afonsus1997/Tamagotchi-thing/README.md

# Tamagotchi Thing

Just a dumb attempt to make a tamagotch.

Based on the amazing work of [jcrona](https://github.com/jcrona)!

#### Credits

3D models:
 - Kailh buttons by Manh Le
