afonsus1997/Tamagotchi-thing/Hardware/Tamagotchi-thing/Tamagotchi-thing.kicad_pcb

## KiCad design Hardware/Tamagotchi-thing/Tamagotchi-thing.kicad_pcb (2025-07-16)

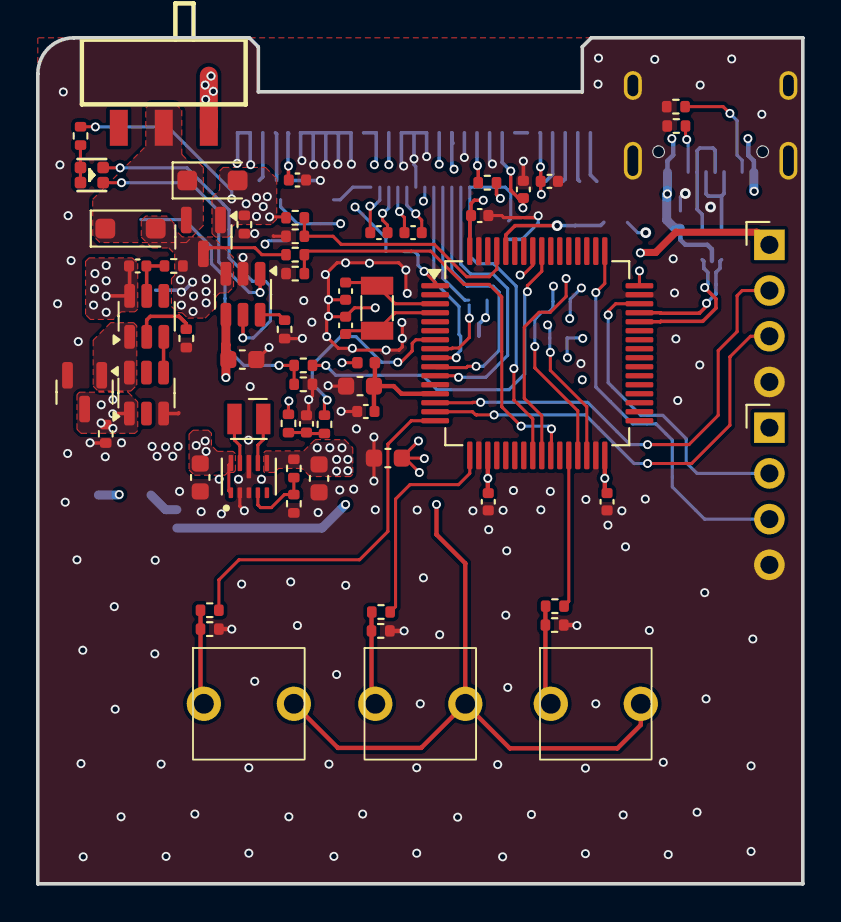
[picture p1: board Tamagotchi-thing.kicad_pcb from above]

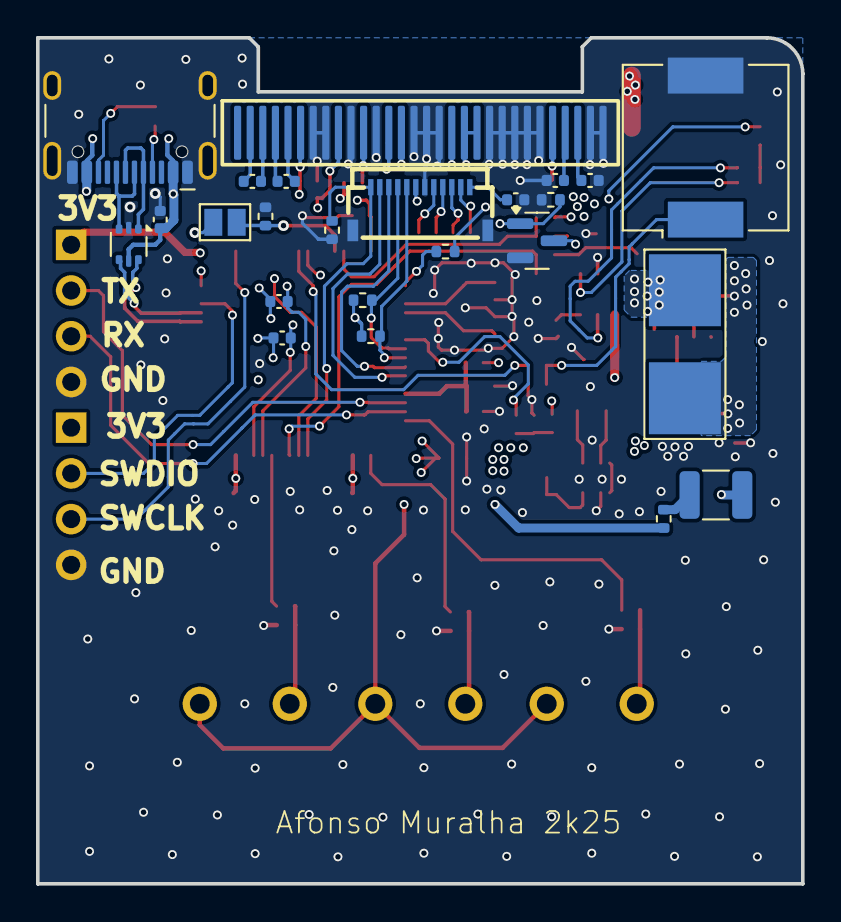
[picture p2: board Tamagotchi-thing.kicad_pcb from below]

Board: 4 copper layers, 42.5 x 47.0 mm, 86 parts (24 on the bottom side), 69 nets.

Parts:
BT1: Battery; Battery_Pads_4x4
C4, C5, C6: 1uF; C_0402_1005Metric
C7, C9, C10, C11, C12: 2.2uF; C_0402_1005Metric
C8: 4.7uF; C_0402_1005Metric
C13, C14: 12pF; C_0402_1005Metric
C15, C19, C20, C21, C24, C28: 100nF; C_0402_1005Metric
C18: 10nF; C_0603_1608Metric
C22: 1uF; C_0603_1608Metric
C23: 10nF; C_0402_1005Metric
C25, C27: 10uF; C_0603_1608Metric
C26: 22uF; C_0603_1608Metric
D1, D2: D_Schottky; D_SOD-123F
D3: LED_Dual_KKA; LED-SMD_4P-L1.6-W1.5-TL-1
J1: Conn_01x14; R_1210_3225Metric
J3: Conn_01x30; FFC-SMD_12P-P0.50_FH34SRJ-12S-0.5SH
J5: Conn_01x30; sh1106-1.3inch-oled_1
J6: USB_C_Receptacle_USB2.0; USB_C_Receptacle_HCTL_HC-TYPE-C-16P-01A
J7, J8: Conn_01x04; PinHeader_1x04_P2.54mm_Horizontal
JP1: SolderJumper_2_Open; SolderJumper-2_P1.3mm_Open_Pad1.0x1.5mm
L1: 39nH; L_0402_1005Metric
L2: 0.47uH; L_Wurth_WE-LQSH-2010
LS1: Speaker_Crystal; Buzzer_CUI_CPT-9019S-SMT
Q1: BSS138; SOT-23
Q3, Q4: AO3401A; SOT-23
Q5: FS8205A; SOT-23-6
R1: 15; R_0402_1005Metric
R2, R3, R4: 10k; R_0402_1005Metric
R6, R7, R11, R15, R16, R17, R18, R19, R22, R28, R32, R33: 100k; R_0402_1005Metric
R8, R9: 4.7k; C_0402_1005Metric
R10: 390k; C_0402_1005Metric
R12, R21, R27, R31: 330; R_0402_1005Metric
R13, R14: 5.1k; R_0402_1005Metric
R20, R34: 0; R_0402_1005Metric
R25, R35: 100; R_0402_1005Metric
R26, R36: 1k; R_0402_1005Metric
R37: 511k; R_0402_1005Metric
R38: 91k; R_0402_1005Metric
R39: 2k; R_0402_1005Metric
R42: 1.6k; R_0402_1005Metric
SW2, SW4, SW5: SW_Push; Kailh_mouse_button
SW6: SW_SPDT_321; SW-SMD_SK-3245S-L1-A-1
U1: USBLC6-2P6; SOT-666
U2: STM32L073RBTx; LQFP-64_10x10mm_P0.5mm
U3: DW01A; SOT-23-6
U4: TPS63802DLAR; VREG_TPS63802DLAR
U5: TP4057; TSOT-23-6
Y1: 32768Hz - 12,5 pF; Crystal_SMD_3215-2Pin_3.2x1.5mm

Connections:
3V3: C7.2, C10.2, C18.1, C19.1, C20.1, C21.1, C26.1, J3.7, J5.6, J5.9, J5.13, J7.1, J8.1, JP1.1 (A), L1.1, R1.2, R3.1, R4.1, R7.2, R8.2, R9.2, R11.1, R20.1, R37.1, SW2.2, SW4.2, SW5.2, U2.19 (VDD), U2.32 (VDD), U2.48 (VDD_USB), U2.64 (VDD), U4.6 (VOUT)
3V3A: C22.1, C23.1, L1.2, U2.13 (VDDA)
/MCU/BOOT0: JP1.2 (B), R15.1, U2.60 (BOOT0)
/MCU/LCD2.SCL: J3.9, R4.2, U2.8 (I2C3_SCL)
/MCU/LCD2.SDA: J3.8, R3.2, U2.9 (I2C3_SDA)
/MCU/LCD2_A0: J3.10, U2.10 (PC2)
/MCU/LCD2_BL_EN: Q1.1 (G), R2.1, U2.57 (TIM3_CH2)
/MCU/LCD2_CS: J3.12, R6.1, U2.24 (PC4)
/MCU/LCD2_RES: J3.11, U2.11 (PC3)
/MCU/OLED.SCL: J5.18, R8.1, U2.29 (I2C2_SCL)
/MCU/OLED.SDA: J5.19, J5.20, R9.1, U2.30 (I2C2_SDA)
/MCU/OLED_RST: J5.14, U2.25 (PC5)
/MCU/OSC_32_IN: C13.1, U2.3 (RCC_OSC32_IN), Y1.1
/MCU/OSC_32_OUT: C14.1, U2.4 (RCC_OSC32_OUT), Y1.2
/MCU/RST: R12.2, U2.7 (NRST)
/MCU/SPK: R25.2, U2.56 (TIM3_CH1)
/MCU/SWCLK: J7.3, U2.49 (SYS_SWCLK)
/MCU/SWDIO: J7.2, U2.46 (SYS_SWDIO)
/MCU/SW_CENTER: R27.1, U2.17 (PA3)
/MCU/SW_LEFT: R21.1, U2.16 (PA2)
/MCU/SW_RIGHT: R31.1, U2.28 (PB2)
/MCU/UART_RX: J8.3, U2.15 (USART4_RX)
/MCU/UART_TX: J8.2, U2.14 (USART4_TX)
/MCU/USB_D_N: U1.6 (I/O1), U2.44 (USB_DM)
/MCU/USB_D_P: U1.4 (I/O2), U2.45 (USB_DP)
/MCU/USB_D_RAW_N: J6.A7 (D-), J6.B7 (D-), U1.1 (I/O1)
/MCU/USB_D_RAW_P: J6.A6 (D+), J6.B6 (D+), U1.3 (I/O2)
/MCU/VBAT_SENSE: R18.2, R19.1, U2.26 (ADC_IN8)
/MCU/VBUS_SENSE: R16.2, R17.1, U2.61 (PB8)
/OLED/BS1: J5.11, R7.1
GND: C4.2, C7.1, C8.1, C10.1, C11.1, C13.2, C14.2, C15.2, C18.2, C19.2, C20.2, C21.2, C22.2, C23.2, C25.2, C26.2, C27.2, C28.2, J3.6, J3.MP (MountPin), J5.7, J5.8, J5.10, J5.12, J5.15, J5.16, J5.17, J5.21, J5.22, J5.23, J5.24, J5.25, J5.29, J5.30, J6.A1 (GND), J6.A12 (GND), J6.B1 (GND), J6.B12 (GND), J6.S1 (SHIELD), J7.4, J8.4, LS1.2, Q1.2 (S), Q4.2 (S), Q5.3 (S2), R2.2, R6.2, R10.1, R13.2, R14.2, R15.2, R17.2, R19.2, R22.2, R26.2, R28.2, R32.2, R33.2, R34.2, R36.2, R38.2, R42.2, U1.2 (GND), U2.12 (VSSA), U2.18 (VSS), U2.31 (VSS), U2.47 (VSS), U2.63 (VSS), U4.2 (MODE), U4.3 (AGND), U4.8 (GND), U5.2 (GND)
GND_BAT: BT1.2 (-), C24.2, Q4.3 (D), Q5.1 (D1), R34.1, U3.6 (GND)
unnamed: C15.1, R11.2, R12.1
unnamed: D1.1 (K), D2.1 (K), Q3.2 (S), SW6.2 (B)
unnamed: D3.3 (A2), D3.4 (A1), R39.2
unnamed: D3.1 (K1), U5.1 (~CHRG)
unnamed: D3.2 (K2), U5.5 (STDBY)
unnamed: J1.1, R1.1
unnamed: J1.2, Q1.3 (D)
unnamed: C4.1, J3.1
unnamed: C5.1, J3.2
unnamed: C5.2, J3.3
unnamed: C6.1, J3.4
unnamed: C6.2, J3.5
unnamed: C12.2, J5.2
unnamed: C12.1, J5.3
unnamed: C9.2, J5.4
unnamed: C9.1, J5.5
unnamed: J5.26, R10.2
unnamed: C8.2, J5.27
unnamed: C11.2, J5.28
unnamed: J6.A5 (CC1), R14.1
unnamed: J6.B5 (CC2), R13.1
unnamed: LS1.1, R25.1, R26.1
unnamed: Q4.1 (G), Q5.6 (G1), U3.1 (OD)
unnamed: Q5.4 (G2), U3.3 (OC)
unnamed: R21.2, R22.1, SW2.1
unnamed: R27.2, R28.1, SW4.1
unnamed: R31.2, R32.1, SW5.1
unnamed: C25.1, SW6.3 (A), U4.1 (EN), U4.10 (VIN)
unnamed: R20.2, U2.1 (VLCD)
unnamed: R36.1, U3.2 (CS)
unnamed: C24.1, R35.2, U3.5 (VCC)
unnamed: R37.2, R38.1, U4.4 (FB)
unnamed: L2.1, U4.9 (L1)
unnamed: L2.2, U4.7 (L2)
unnamed: R42.1, U5.6 (PROG)
VBAT: BT1.1 (+), D2.2 (A), Q3.3 (D), R18.1, R35.1, U5.3 (BAT)
VBUS: C27.1, C28.1, D1.2 (A), J6.A4 (VBUS), J6.A9 (VBUS), J6.B4 (VBUS), J6.B9 (VBUS), Q3.1 (G), R16.1, R33.1, R39.1, U1.5 (VBUS), U5.4 (V_{CC})
