afonsus1997/Tamagotchi-thing/Software/Tamagotchi-thing/Core/Src/main.c

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
/* Includes ------------------------------------------------------------------*/
#include "main.h"
#include "adc.h"
#include "fatfs.h"
#include "i2c.h"
#include "rtc.h"
#include "spi.h"
#include "tim.h"
#include "usart.h"
#include "usb.h"
#include "gpio.h"

/* USER CODE BEGIN Includes */
#include "ssd1306.h"
#include "ssd1306_fonts.h"
#include "ui.h"
#include "userio.h"
#include "usb_user.h" 
#include "log.h"
#include "hal.h"
#include "tamalib.h"
#include "tama_user.h"
/* USER CODE END Includes */


void SystemClock_Config(void);
/* USER CODE BEGIN 0 */

void debug_blink_box(void) {
    static timestamp_t last = 0;
    static bool_t on = false;

    timestamp_t now = hal_get_timestamp();
    if ((now - last) >= MCU_TIME_FREQ_HZ) { // 1 second
        last = now;
        on = !on;

        u8g2_ClearBuffer(&u8g2);
        if (on) {
            u8g2_DrawBox(&u8g2, 0, 0, 8, 8);  // small box in corner
        }
        u8g2_SendBuffer(&u8g2);
    }
}

void debug_tick_counter(void) {
    static timestamp_t last_ts = 0;
    static uint32_t real_seconds = 0;

    timestamp_t now = hal_get_timestamp();
    static uint32_t tick_start = 0;

    if (last_ts == 0) {
        last_ts = now;
        tick_start = now;
    }

    if ((now - last_ts) >= 32768) { // every approx second (just a guess for now)
        last_ts = now;
        real_seconds++;

        // Estimate actual frequency
        uint32_t ticks_elapsed = now - tick_start;
        uint32_t freq_est = ticks_elapsed / real_seconds;

        char buf[32];
        u8g2_ClearBuffer(&u8g2);
        u8g2_SetFont(&u8g2, u8g2_font_8x13_mn);
        snprintf(buf, sizeof(buf), "Ticks: %lu", freq_est);
        u8g2_DrawStr(&u8g2, 0, 12, buf);
        snprintf(buf, sizeof(buf), "Ticks: %lu", __HAL_TIM_GET_COUNTER(&htim6));
        u8g2_DrawStr(&u8g2, 0, 24, buf);

        u8g2_SendBuffer(&u8g2);
    }
}

static timestamp_t screen_ts = 0;


/* USER CODE END 0 */

/**
  * @brief  The application entry point.
  * @retval int
  */
int main(void)
{

  /* MCU Configuration--------------------------------------------------------*/

  /* Reset of all peripherals, Initializes the Flash interface and the Systick. */
  HAL_Init();

  /* Configure the system clock */
  SystemClock_Config();

  /* Initialize all configured peripherals */
  MX_GPIO_Init();
  MX_ADC_Init();
  MX_RTC_Init();
  MX_I2C2_Init();
  MX_I2C3_Init();
  MX_SPI1_Init();
  MX_TIM3_Init();
  MX_USART4_UART_Init();
  MX_FATFS_Init();
  MX_USB_PCD_Init();
  MX_TIM7_Init();
  MX_TIM6_Init();
  /* USER CODE BEGIN 2 */
  // Init OLED
  
  ui_init_display();
  userio_init();
  HAL_TIM_Base_Start_IT(&htim7);
  HAL_TIM_Base_Start_IT(&htim6);
  usb_user_init();
  log_init_printf(LOG_INT);
  tama_user_init();
  LOG_INFO("Initialization complete");
  /* USER CODE END 2 */

  /* Infinite loop */
  /* USER CODE BEGIN WHILE */
  ui_loop();
  while (1)
  {
        // tamalib_mainloop();

        userio_process();
        tamalib_step();
        hal_handler();
	      timestamp_t ts;
        ts = g_hal->get_timestamp();
		      if (ts - screen_ts >= 524288/4) {
			      screen_ts = ts;
			      g_hal->update_screen();
		    }

    /* USER CODE END WHILE */

    /* USER CODE BEGIN 3 */
  }
  /* USER CODE END 3 */
}

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
/**
  * @brief  Period elapsed callback in non blocking mode
  * @note   This function is called  when TIM2 interrupt took place, inside
  * HAL_TIM_IRQHandler(). It makes a direct call to HAL_IncTick() to increment
  * a global variable "uwTick" used as application time base.
  * @param  htim : TIM handle
  * @retval None
  */
void HAL_TIM_PeriodElapsedCallback(TIM_HandleTypeDef *htim)
{
  if (htim->Instance == TIM2)
  {
    HAL_IncTick();
  }
  /* USER CODE BEGIN Callback 1 */
  if (htim->Instance == TIM7)
  {
    // ui_force_redraw();  
  }
  if (htim->Instance == TIM6) {
    tim_increment_ticks();  // 16-bit overflow occurred
  }
  /* USER CODE END Callback 1 */
}

/**
  * @brief  This function is executed in case of error occurrence.
  * @retval None
  */
void Error_Handler(void)
{
  /* USER CODE BEGIN Error_Handler_Debug */
  /* User can add his own implementation to report the HAL error return state */
  __disable_irq();
  while (1)
  {
  }
  /* USER CODE END Error_Handler_Debug */
}
#ifdef USE_FULL_ASSERT
/**
  * @brief  Reports the name of the source file and the source line number
  *         where the assert_param error has occurred.
  * @param  file: pointer to the source file name
  * @param  line: assert_param error line source number
  * @retval None
  */
void assert_failed(uint8_t *file, uint32_t line)
{
  /* USER CODE BEGIN 6 */
  /* User can add his own implementation to report the file name and line number,
     ex: printf("Wrong parameters value: file %s on line %d\r\n", file, line) */
  /* USER CODE END 6 */
}
#endif /* USE_FULL_ASSERT */
