afonsus1997/Tamagotchi-thing/Software/Tamagotchi-thing/TamagotchiThing.ioc

Mcu.UserName=STM32L073RBTx
PA0.Signal=USART4_TX
PA1.Signal=USART4_RX
PA11.Signal=USB_DM
PA12.Signal=USB_DP
PA13.Signal=SYS_SWDIO
PA14.Signal=SYS_SWCLK
PA2.GPIO_Label=SW_LEFT
PA2.Signal=GPIO_Input
PA3.GPIO_Label=SW_CENTER
PA3.Signal=GPIO_Input
PA4.Signal=SPI1_NSS
PA5.Signal=SPI1_SCK
PA6.Signal=SPI1_MISO
PA7.Signal=SPI1_MOSI
PA8.GPIO_Label=LCD_DC
PA8.Signal=GPIO_Output
PB0.GPIO_Label=VBAT_SENSE
PB0.Signal=ADC_IN8
PB1.GPIO_Label=LCD_BL
PB1.Signal=S_TIM3_CH4
PB10.Signal=I2C2_SCL
PB11.Signal=I2C2_SDA
PB2.GPIO_Label=SW_RIGHT
PB2.Signal=GPIO_Input
PB4.GPIO_Label=SPK
PB4.Signal=S_TIM3_CH1
PB5.GPIO_Label=LCD2_BL
PB5.Signal=S_TIM3_CH2
PB8.GPIO_Label=VBUS_SENSE
PB8.Signal=GPIO_Input
PC0.Signal=I2C3_SCL
PC1.Signal=I2C3_SDA
PC13.Signal=RTC_TS
PC14-OSC32_IN.Signal=RCC_OSC32_IN
PC15-OSC32_OUT.Signal=RCC_OSC32_OUT
PC2.GPIO_Label=LCD2_A0
PC2.Signal=GPIO_Output
PC3.GPIO_Label=LCD2_RES
PC3.Signal=GPIO_Output
PC4.GPIO_Label=LCD2_CS
PC4.Signal=GPIO_Output
PC5.GPIO_Label=OLED_RST
PC5.Signal=GPIO_Output
