afonsus1997/Tamagotchi-thing/Software/Tamagotchi-thing/Core/Src/userio/userio.h

#if !defined(USERIO_H)
#define USERIO_H

#include "main.h"
#include "lwbtn.h"
#include "ui.h"
#include "lwbtn_opts.h"

enum btnsIdx_e
{
  BUTTON_RIGHT = 0,
  BUTTON_CENTER,
  BUTTON_LEFT,
  BUTTONS_TOTAL
}; 

extern uint8_t btn_states[3];
extern lwbtn_btn_t btns[];

void userio_process();
void userio_init();

extern const int buttons_id[BUTTONS_TOTAL];


#endif // USERIO_H
