afonsus1997/Tamagotchi-thing/Software/Tamagotchi-thing/Core/Src/flash/flash.c

#include "flash.h"
static void flash_read(uint32_t addr, uint32_t *data, uint32_t length)
{
	__IO uint32_t *ptr = (__IO uint32_t *) addr;

	while (length-- > 0) {
		*(data++) = *(ptr++);
	}
}

static int8_t flash_write(uint32_t addr, uint32_t *data, uint32_t length)
{
	__IO uint32_t *ptr = (__IO uint32_t *) addr;
	HAL_StatusTypeDef status;

	while (length-- > 0) {
		status = HAL_FLASH_Program(FLASH_TYPEPROGRAM_WORD, (uint32_t) (ptr++), (uint32_t) *(data++));
		if (status != HAL_OK) {
			return -1;
		}
	}

	return 0;
}

static int16_t flash_erase_page(uint32_t addr)
{
	uint32_t error;

	FLASH_EraseInitTypeDef erase_init;

	erase_init.TypeErase = FLASH_TYPEERASE_PAGES;
	erase_init.PageAddress = addr;
	erase_init.NbPages = 1;

	return (HAL_FLASHEx_Erase(&erase_init, &error) == HAL_OK ? 0 : -1);
}

int8_t storage_read(uint32_t offset, uint32_t *data, uint32_t length)
{
	if (length == 0) {
		/* Nothing to do */
		return 0;
	}

	if ((offset + length) * sizeof(uint32_t) > STORAGE_SIZE) {
		return -1;
	}

	flash_read(STORAGE_BASE_ADDRESS + (offset << 2), data, length);

	return 0;
}

static int8_t write_within_page(uint32_t addr, uint32_t *data, uint32_t length)
{
	uint32_t page[STORAGE_PAGE_SIZE];
	uint32_t page_addr = addr & ~((STORAGE_PAGE_SIZE << 2) - 1);
	uint32_t offset_in_page = (addr >> 2) & (STORAGE_PAGE_SIZE - 1);
	uint32_t i = 0;

	if (length > STORAGE_PAGE_SIZE - offset_in_page) {
		return -1;
	}

	/* Read the page if needed */
	if (offset_in_page != 0 ||  length < STORAGE_PAGE_SIZE) {
		flash_read(page_addr, page, STORAGE_PAGE_SIZE);
	}

	/* Update the page */
	for (i = 0; i < length; i++) {
		page[offset_in_page + i] = data[i];
	}

	/* Erase the page */
	if (flash_erase_page(page_addr) < 0) {
		return -1;
	}

	/* Write the page back */
	if (flash_write(page_addr, page, STORAGE_PAGE_SIZE) < 0) {
		return -1;
	}

	return 0;
}

int8_t storage_write(uint32_t offset, uint32_t *data, uint32_t length)
{
	uint32_t page_len;
	uint32_t addr = STORAGE_BASE_ADDRESS + (offset << 2);

	HAL_FLASH_Unlock();

	while (length > 0) {
		/* Either a first partial page or a full page */
		page_len = STORAGE_PAGE_SIZE - ((addr >> 2) & (STORAGE_PAGE_SIZE - 1));

		if (page_len > length) {
			/* Partial page */
			page_len = length;
		}

		if (write_within_page(addr, data, page_len) < 0) {
			HAL_FLASH_Lock();
			return -1;
		}

		addr += page_len << 2;
		data += page_len;
		length -= page_len;
	}

	HAL_FLASH_Lock();

	return 0;
}

int8_t storage_erase(void)
{
	uint32_t i;

	HAL_FLASH_Unlock();

	for (i = 0; i < (STORAGE_SIZE >> 2)/STORAGE_PAGE_SIZE; i++) {
		if (flash_erase_page(STORAGE_BASE_ADDRESS + i * (STORAGE_PAGE_SIZE << 2)) < 0) {
			HAL_FLASH_Lock();
			return -1;
		}
	}

	HAL_FLASH_Lock();

	return 0;
}
