afonsus1997/Tamagotchi-thing/Software/Tamagotchi-thing/Core/Src/tama_user/tama_storage.h

#ifndef __TAMA_STORAGE__H__
#define __TAMA_STORAGE__H__

#include "main.h"
#include "log.h"
#include "flash.h"
#include "hal_types.h"


#define ROM_BUILT_IN

#ifdef ROM_BUILT_IN
#include "rom_tamatool.h"
#endif

#endif  //!__TAMA_STORAGE__H__
