afonsus1997/Tamagotchi-thing/Software/Tamagotchi-thing/Core/Src/tama_user/tama_icons.h

#ifndef __TAMA_ICONS__H__
#define __TAMA_ICONS__H__

#include "tama_user.h"

#define ICON_SIZE					8
#define ICON_NUM 8


static const bool_t icons[ICON_NUM][ICON_SIZE][ICON_SIZE] = {
	{
		{1, 0, 1, 0, 1, 0, 0, 1},
		{1, 0, 1, 0, 1, 0, 1, 1},
		{1, 1, 1, 1, 1, 0, 1, 1},
		{0, 1, 1, 1, 0, 1, 1, 1},
		{0, 0, 1, 0, 0, 1, 1, 1},
		{0, 0, 1, 0, 0, 0, 1, 1},
		{0, 0, 1, 0, 0, 0, 0, 1},
		{0, 0, 1, 0, 0, 0, 0, 1},
	},
	{
		{0, 1, 0, 0, 0, 0, 1, 0},
		{0, 0, 0, 1, 1, 0, 0, 0},
		{1, 0, 1, 0, 0, 1, 0, 1},
		{0, 0, 1, 0, 0, 1, 0, 0},
		{0, 0, 0, 1, 1, 0, 0, 0},
		{0, 1, 0, 0, 0, 0, 1, 0},
		{0, 0, 0, 1, 1, 0, 0, 0},
		{0, 0, 0, 0, 0, 0, 0, 0},
	},
	{
		{1, 1, 1, 0, 0, 1, 1, 1},
		{1, 0, 1, 0, 1, 1, 1, 1},
		{1, 1, 1, 0, 1, 1, 1, 1},
		{0, 0, 0, 1, 1, 1, 1, 0},
		{0, 0, 1, 1, 1, 0, 0, 0},
		{0, 0, 1, 1, 0, 0, 0, 0},
		{1, 1, 0, 0, 0, 0, 0, 0},
		{1, 1, 0, 0, 0, 0, 0, 0},
	},
	{
		{0, 0, 0, 1, 1, 1, 0, 0},
		{0, 0, 0, 0, 1, 1, 1, 0},
		{0, 0, 0, 1, 1, 1, 1, 1},
		{0, 0, 1, 1, 0, 1, 1, 1},
		{0, 1, 1, 0, 1, 1, 0, 1},
		{0, 1, 1, 1, 1, 0, 0, 0},
		{1, 1, 1, 1, 0, 0, 0, 0},
		{1, 1, 0, 0, 0, 0, 0, 0},
	},
	{
		{0, 1, 1, 0, 0, 0, 0, 0},
		{1, 0, 0, 1, 0, 0, 1, 1},
		{1, 0, 0, 1, 1, 1, 0, 1},
		{0, 1, 0, 1, 0, 0, 1, 1},
		{0, 1, 0, 0, 1, 1, 0, 1},
		{0, 1, 0, 0, 0, 0, 0, 1},
		{0, 1, 1, 0, 0, 0, 1, 1},
		{0, 0, 1, 1, 1, 1, 1, 0},
	},
	{
		{0, 0, 0, 0, 0, 0, 0, 0},
		{0, 1, 1, 1, 1, 1, 1, 0},
		{1, 0, 0, 0, 0, 0, 0, 1},
		{1, 0, 1, 0, 1, 0, 1, 1},
		{1, 0, 1, 0, 1, 0, 1, 1},
		{1, 0, 0, 1, 0, 0, 0, 1},
		{0, 1, 0, 0, 1, 0, 1, 0},
		{0, 0, 1, 1, 1, 1, 0, 0},
	},
	{
		{0, 0, 0, 0, 0, 0, 0, 0},
		{0, 0, 0, 0, 0, 0, 1, 0},
		{0, 0, 0, 0, 0, 1, 0, 1},
		{0, 1, 1, 1, 0, 1, 0, 1},
		{1, 1, 1, 0, 0, 1, 0, 1},
		{1, 1, 0, 0, 1, 0, 1, 0},
		{1, 1, 1, 0, 0, 0, 0, 0},
		{0, 1, 1, 1, 0, 0, 0, 0},
	},
	{
		{0, 0, 0, 0, 0, 0, 0, 0},
		{0, 1, 1, 1, 0, 0, 0, 0},
		{1, 0, 0, 0, 1, 0, 0, 0},
		{1, 1, 0, 1, 1, 1, 1, 0},
		{1, 0, 1, 0, 0, 1, 0, 1},
		{0, 1, 1, 1, 1, 0, 1, 1},
		{0, 0, 0, 1, 0, 0, 0, 1},
		{0, 0, 0, 0, 1, 1, 1, 0},
	},
};
#endif  //!__TAMA_ICONS__H__
