afonsus1997/Tamagotchi-thing/Software/Tamagotchi-thing/Core/Src/ui/forms.h

#ifndef __FORMS__H__
#define __FORMS__H__

#include "ui.h"
#include "main.h"
#include "mui.h"
#include "rtc.h"
#include <stdio.h>

static const unsigned char image_Alert_bits[] = {0x10,0x00,0x38,0x00,0x28,0x00,0x6c,0x00,0x6c,0x00,0xfe,0x00,0xee,0x00,0xff,0x01};
static const unsigned char image_Battery_bits[] = {0xfe,0xff,0x7f,0x00,0x01,0x00,0x80,0x00,0x01,0x00,0x80,0x03,0x01,0x00,0x80,0x02,0x01,0x00,0x80,0x02,0x01,0x00,0x80,0x03,0x01,0x00,0x80,0x00,0xfe,0xff,0x7f,0x00};
static const unsigned char image_Charging_lightning_bits[] = {0x40,0x01,0xa0,0x00,0x50,0x00,0xe8,0x01,0x84,0x00,0x42,0x00,0x2f,0x00,0x14,0x00,0x0a,0x00,0x05,0x00};

void draw_main_menu_title(uint8_t battery);
uint8_t forms_about_screen(mui_t *ui, uint8_t msg);


#endif  //!__FORMS__H__
