afonsus1997/Tamagotchi-thing/(commit log)

2025-07-15 schematic work
    [OLED.kicad_sch, Tamagotchi-thing.kicad_sch, mcu.kicad_sch, power.kicad_sch]
2025-07-15 Schematic and layout work
2025-07-16 Schematic and Layout work. DRC cleanup
    [Tamagotchi-thing.kicad_pcb]
2025-07-16 Final touches. Exported production files
    [OLED.kicad_sch, Tamagotchi-thing.kicad_pcb, bom.csv, designators.csv, mcu.kicad_sch, positions.csv, power.kicad_sch]
2025-07-16 Minor fixes. Added via stitching. BOM adjustments. Sent to production
    [OLED.kicad_sch, Tamagotchi-thing.kicad_pcb, bom.csv]
2025-07-29 Replaced sw project with cmake project
    [TamagotchiThing.ioc, main.c, main.h, rtc.c]
2025-07-30 updated u8g2, changed i2c speed to 400kHz
2025-07-30 organization and button userui stuff
2025-08-01 forms and buttons
2025-08-02 fixed buttons
2025-08-06 Added button handling to emulation
