afonsus1997/Tamagotchi-thing/(notices)

Notices in the files:
Software/Tamagotchi-thing/Core/Src/main.c:
Copyright (c) 2025 STMicroelectronics.
All rights reserved.
This software is licensed under terms that can be found in the LICENSE file
Software/Tamagotchi-thing/Core/Src/flash/flash_glue.c:
modify it under the terms of the GNU General Public License
